phorton1/Arduino-boat-teensyBoat/docs/3dp.md

# teensyBoat.ino - 3DP

**[Home](readme.md)** --
**[Electronics](electronics.md)** --
**3DP** --
**[Commands](commands.md)**

repos: **[phorton1](https://github.com/phorton1)** --
**teensyBoat Firmware** --
**[teensyBoat App](https://github.com/phorton1/base-apps-teensyBoat/blob/master/docs/readme.md)** --
**[Boat Library](https://github.com/phorton1/Arduino-libraries-Boat/blob/master/docs/readme.md)** --
**[tbESP32 WiFi](https://github.com/phorton1/Arduino-boat-tbESP32/blob/master/docs/readme.md)** --
**[teensyWind Tester](https://github.com/phorton1/Arduino-boat-teensyWind/blob/master/docs/readme.md)** --
**[teensyGPS](https://github.com/phorton1/Arduino-boat-teensyGPS/blob/master/docs/readme.md)**

The teensyBoat PCB lives in a custom two-piece 3D-printed enclosure designed in
Fusion 360.  The enclosure holds the PCB securely, exposes all connectors, and mounts
to the installation surface.

TODO: insert Fusion 360 screenshot of enclosure design here

TODO: insert photo of final assembled device (PCB in enclosure) here

## Enclosure Files

Print-ready and slicer files are in `docs/3dp/`:

- **teensyBoatBottom.stl** -- main enclosure body
- **teensyBoatTop.stl** -- top cover
- **teensyBoatBottom.3mf** -- slicer project file for the bottom (Bambu/PrusaSlicer)
- **teensyBoatTop.3mf** -- slicer project file for the top
- **teensyBoatBottom_PETG.gcode** -- pre-sliced printer gcode for PETG filament
- **teensyBoatTop_PETG.gcode** -- pre-sliced printer gcode for PETG filament

The Fusion 360 source (`.f3d`) is not currently included in the repository.

---

**Next:** [Commands](commands.md)
