phorton1/Arduino-boat-teensyBoat/docs/3dp/seatalk_jxn_top.3mf

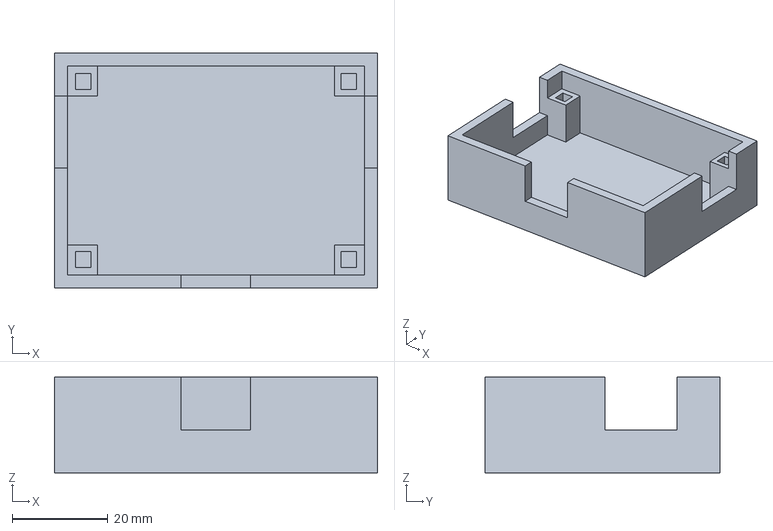
[picture p3: CAD file, 2026-11-11]
docs/3dp/seatalk_jxn_top.3mf
67.4 x 49.1 x 20.0 mm
