phorton1/Arduino-boat-teensyBoat/docs/kicad/board1/board1.step

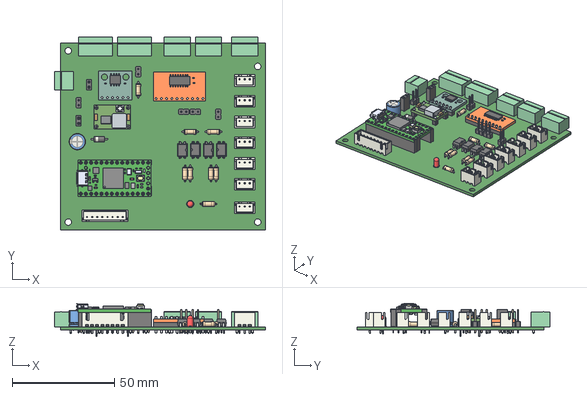
[picture p4: CAD file, 2026-01-05]
docs/kicad/board1/board1.step
103.2 x 94.4 x 16.3 mm
