phorton1/Arduino-boat-teensyBoat/docs/kicad/obs/SeatalkJxn/SeatalkJxn.step

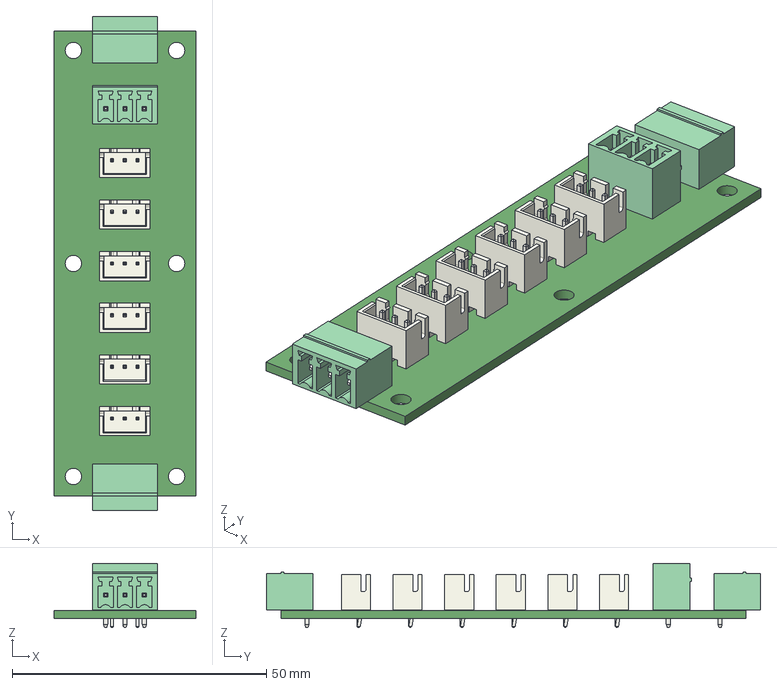
[picture p5: CAD file, 2025-11-19]
docs/kicad/obs/SeatalkJxn/SeatalkJxn.step
27.9 x 97.3 x 12.6 mm
