phorton1/Arduino-boat-teensyBoat/docs/kicad/seatalk_jxn/seatalk_jxn.step

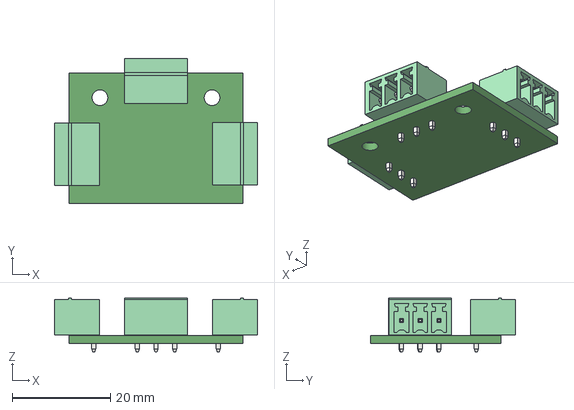
[picture p6: CAD file, 2026-11-11]
docs/kicad/seatalk_jxn/seatalk_jxn.step
41.4 x 29.6 x 10.9 mm
