phorton1/Arduino-boat-teensyBoat/docs/3dp/wire_clamp_3x2.3mf

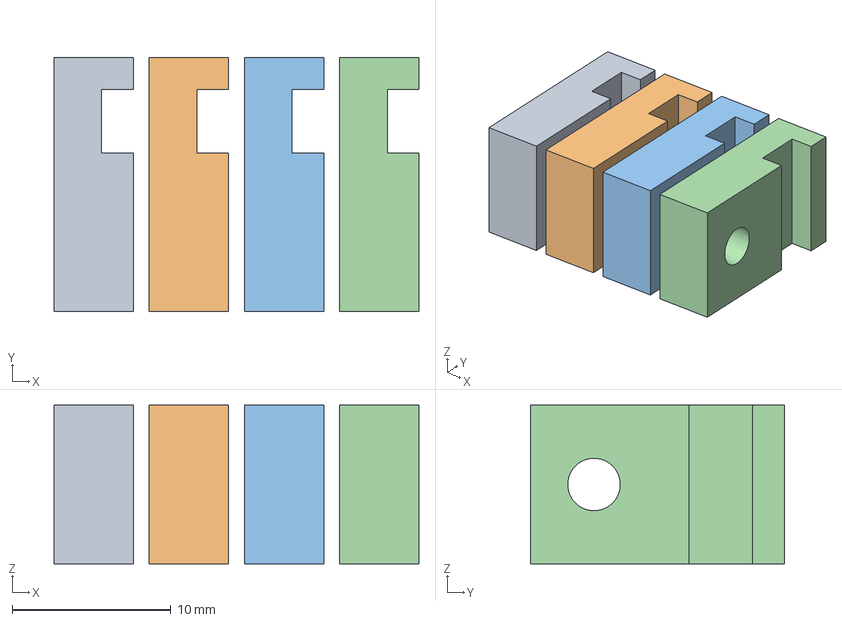
[picture p7: CAD file, 2026-11-11]
docs/3dp/wire_clamp_3x2.3mf
23.0 x 16.0 x 10.0 mm
wire_clamp_3x2.stl x 4
