phorton1/Arduino-boat-teensyBoat/docs/3dp/seatalk_jxn_bottom.3mf

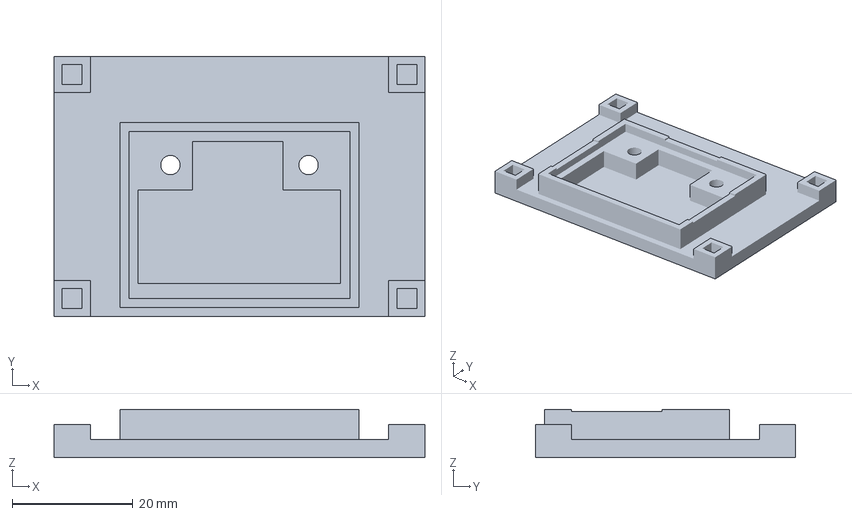
[picture p8: CAD file, 2026-11-11]
docs/3dp/seatalk_jxn_bottom.3mf
61.4 x 43.1 x 8.00 mm
