phorton1/Arduino-boat-teensyBoat/docs/3dp/teensyBoatTop.3mf

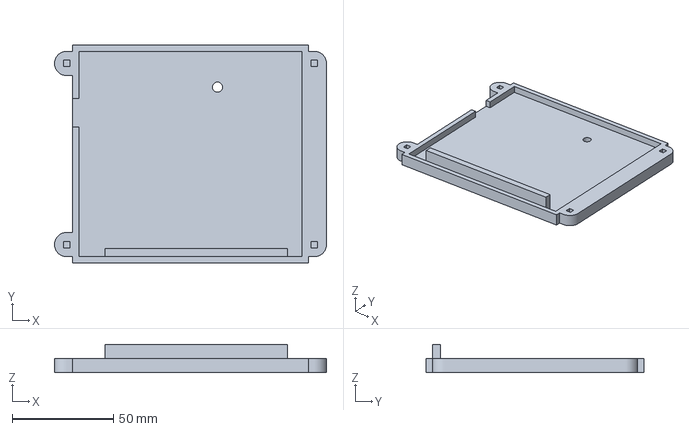
[picture p9: CAD file, 2026-09-30]
docs/3dp/teensyBoatTop.3mf
134.3 x 107.4 x 14.0 mm
