phorton1/Arduino-boat-teensyBoat/docs/3dp/teensyBoatBottom.3mf

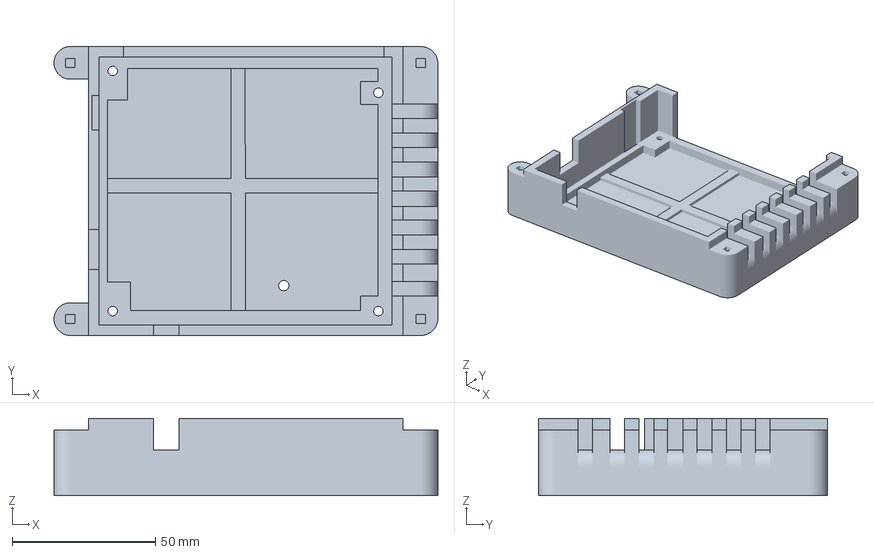
[picture p10: CAD file, 2026-09-30]
docs/3dp/teensyBoatBottom.3mf
134.0 x 100.8 x 27.0 mm
