phorton1/Arduino-boat-teensyBoat/(list of files, cad)

Other CAD files:
docs/3dp/seatalk_jxn_bottom.stl
docs/3dp/seatalk_jxn_top.stl
docs/3dp/teensyBoatBottom.stl
docs/3dp/teensyBoatBoxMagnets.f3d
docs/3dp/teensyBoatTop.stl
docs/3dp/wire_clamp_3x2.stl
