phorton1/Arduino-boat-teensyBoat/docs/kicad/seatalk_jxn/seatalk_jxn.kicad_pcb

## KiCad design docs/kicad/seatalk_jxn/seatalk_jxn.kicad_pcb (2026-11-11)

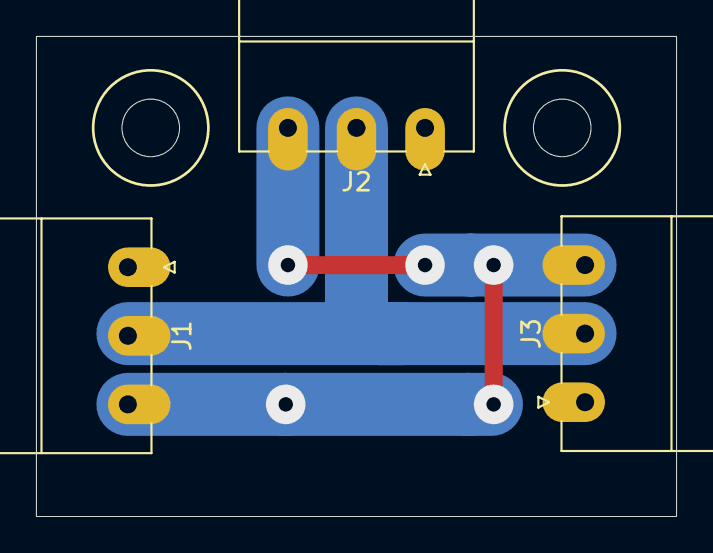
[picture p11: board seatalk_jxn.kicad_pcb from above]

Board: 2 copper layers, 35.6 x 26.7 mm, 3 parts (0 on the bottom side), 3 nets.

Parts:
J1, J2, J3: Conn_01x03; myPheonix3x3.81_right

Connections:
+12V: J1.2, J2.2, J3.2
DATA: J1.3, J2.3, J3.3
GND: J1.1, J2.1, J3.1
