phorton1/Arduino-boat-teensyBoat/docs/kicad/windBreadboard/windBreadboard.kicad_pcb

## KiCad design docs/kicad/windBreadboard/windBreadboard.kicad_pcb (2026-02-14)

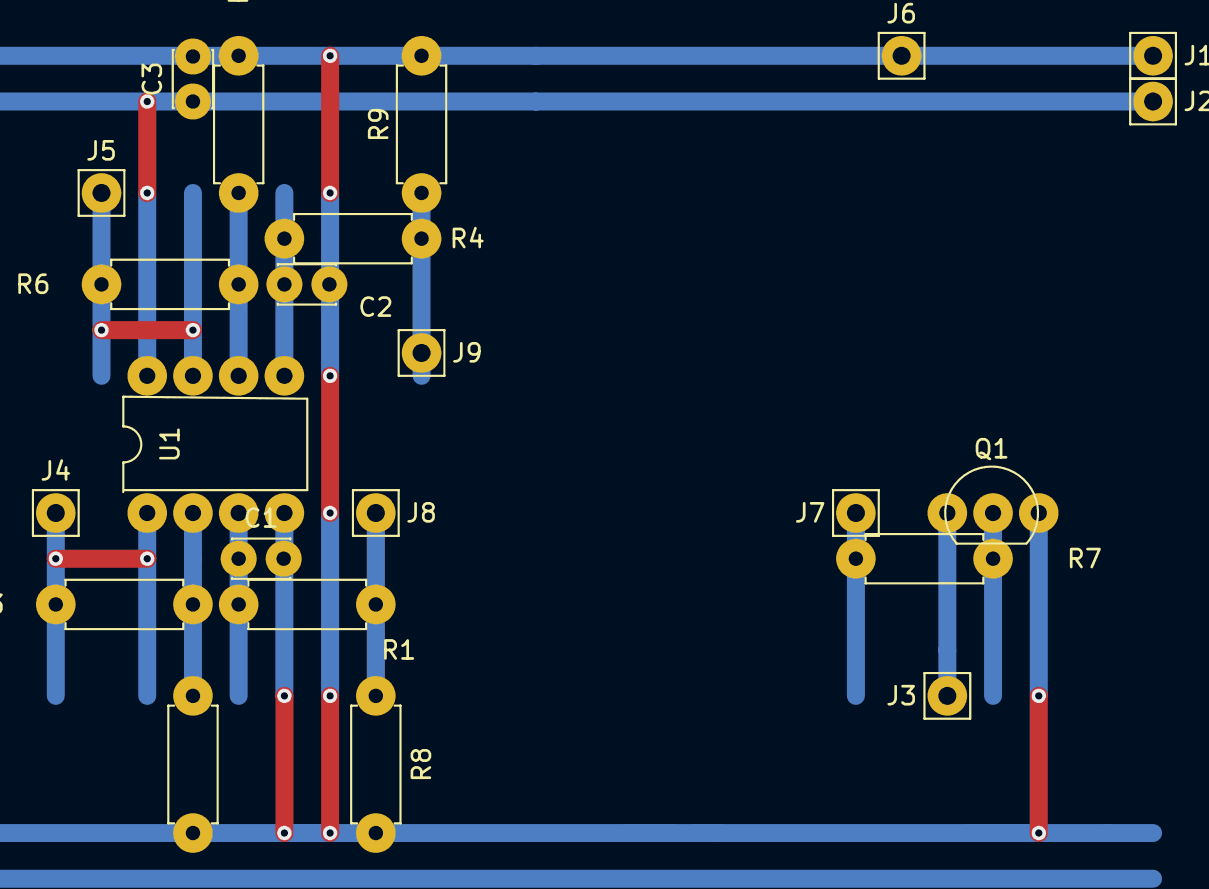
[picture p12: board windBreadboard.kicad_pcb from above]

Board: 2 copper layers, 23 parts (0 on the bottom side), 13 nets.

Parts:
C1, C2, C3: 100nf; myCapCeramicSmall
J1: ST_GND; myPinHeader_1x01
J2: ST_12V; myPinHeader_1x01
J3: WIND_PULSE_YELLOW; myPinHeader_1x01
J4: SIGNALA_GREEN; myPinHeader_1x01
J5: SIGNALB_BLUE; myPinHeader_1x01
J6: GP8_GND; myPinHeader_1x01
J7: GP8_PULSE_YELLOW; myPinHeader_1x01
J8: GP8_PWMA_GREEN; myPinHeader_1x01
J9: GP8_PWMB_BLUE; myPinHeader_1x01
Q1: BC546; myTransistor
R1, R2, R4, R5, R8, R9: 10K; myResistor
R3, R6: 22K; myResistor
R7: 1K; myResistor
U1: LM358; myDip8

Connections:
+12V: C3.1, J2.1, U1.8
GND: C1.2, C2.2, C3.2, J1.1, J6.1, Q1.3, R2.2, R5.2, R8.2, R9.2, U1.4
unnamed: C1.1, R1.1, U1.3
unnamed: C2.1, R4.1, U1.5
unnamed: Q1.2, R7.1
unnamed: R2.1, R3.2, U1.2
unnamed: R5.1, R6.2, U1.6
PWMA_GREEN: J8.1, R1.2, R8.1
PWMB_BLUE: J9.1, R4.2, R9.1
SIGNALA_GREEN: J4.1, R3.1, U1.1
SIGNALB_BLUE: J5.1, R6.1, U1.7
SPEED_PULSE_YELLOW: J7.1, R7.2
WIND_PULSE_YELLOW: J3.1, Q1.1
