phorton1/Arduino-boat-teensyBoat/docs/kicad/board1/board1.kicad_pcb

## KiCad design docs/kicad/board1/board1.kicad_pcb (2026-01-08)

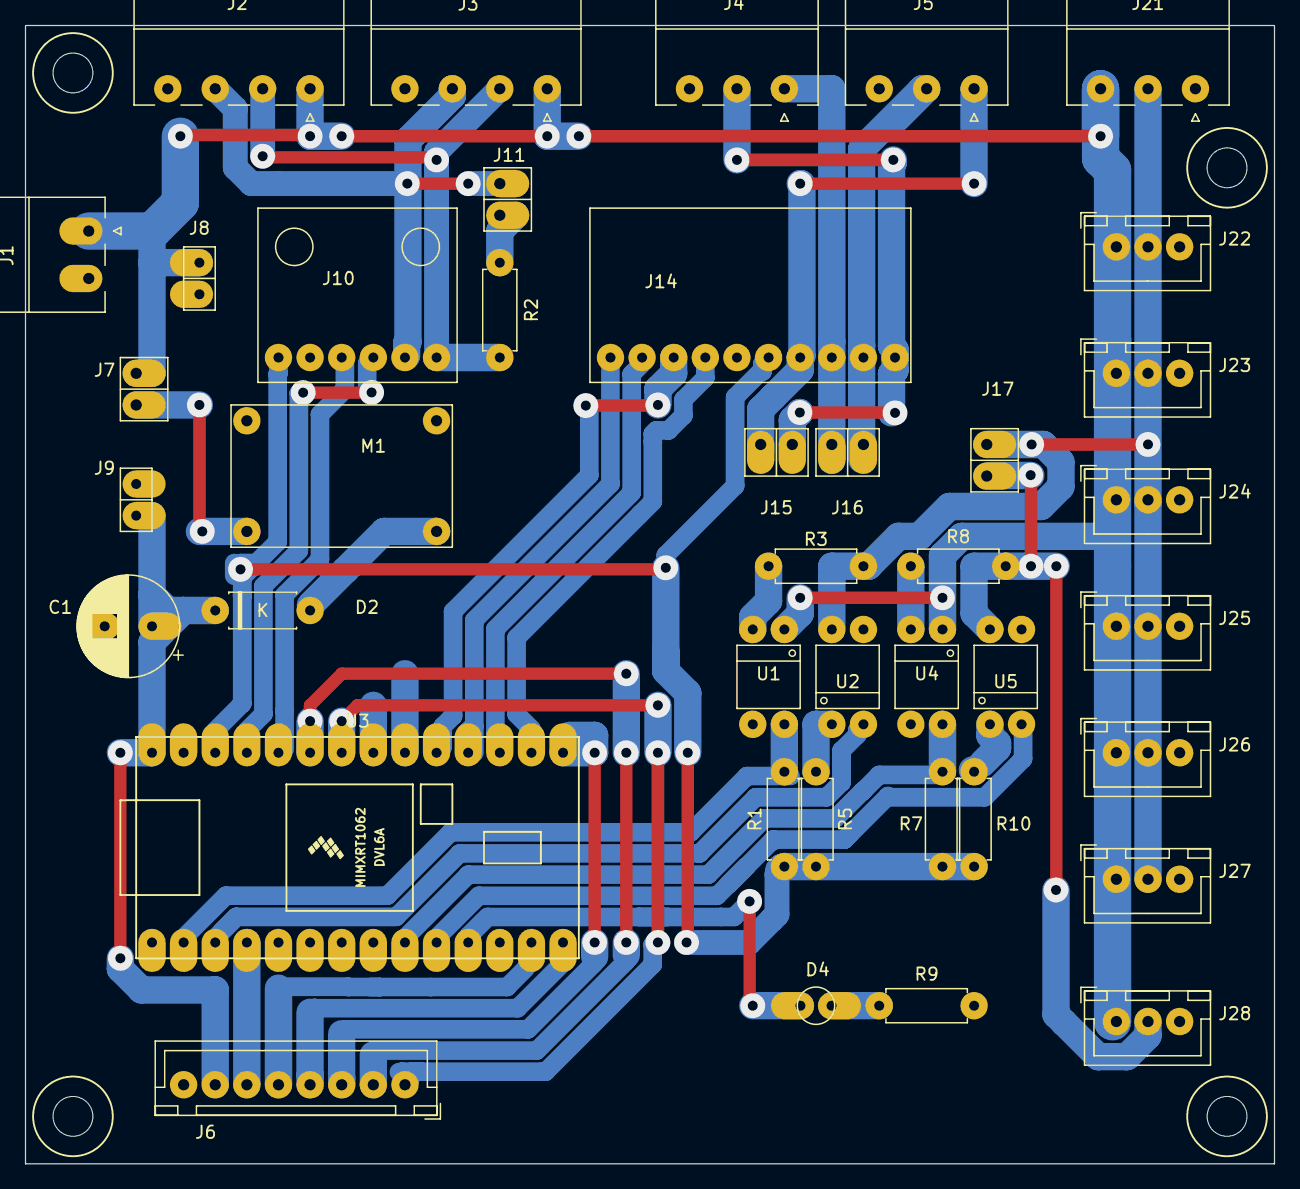
[picture p13: board board1.kicad_pcb from above]

Board: 2 copper layers, 100.3 x 91.4 mm, 40 parts (0 on the bottom side), 37 nets.

Parts:
C1: 100uf; CP_my100uf
D2: 1N5819; myDiodeSchotsky
D4: ALIVE_LED; led_small_red
J1: INST_POWER; myPheonix2x3.81_right
J2, J3: NMEA2000; myPheonix4x3.81_right
J4: 83A; myPheonix3x3.81_right
J5: 83B; myPheonix3x3.81_right
J6: TEST_RIG; myJSTx08
J7: BUCK_PWR; pinHeader1x2
J8: 12V_TEST; pinSocket1x2
J9: 5V_TEST; pinSocket1x2
J10: SN65HVD230; CANBUS_Module1
J11: CAN_TERMINATOR; pinHeader1x2
J14: MAX3232; MAX3232_Module
J15: AIS; pinHeader1x2
J16: GPS; pinHeader1x2
J17: ST_CONNECTED; pinHeader1x2
J21: ST1; myPheonix3x3.81_right
J22, J23, J24, J25, J26, J27: ST1; myJSTx03
J28: ST2; myJSTx03
M1: BUCK01; myMini360BuckConverter
R1: 10K; myResistor
R2: 120; myResistor
R3, R8: 4.7K; myResistor
R5, R9, R10: 220; myResistor
R7: 10k; myResistor
U1, U2, U4, U5: TLP521; myDip4
U3: myTeensy4.0; teensy40

Connections:
83A_IN: J4.2, J14.10, J15.2
83A_OUT: J4.1, J14.8, J16.1
83B_IN: J5.2, J14.9, J16.2
83B_OUT: J5.1, J14.7, J15.1
+3V3: J10.1, J14.6, R1.1, R5.2, R7.1, R10.2, U3.26
+5V: C1.1, D2.1, J6.7, J9.1, U3.28
+12V: J1.1, J2.1, J3.1, J7.2, J8.1, J21.3, J22.1, J23.1, J24.1, J25.1, J26.1, J27.1, J28.1, U1.1, U4.1
ALIVE_LED: D4.2, U3.11
CANH: J2.3, J3.3, J10.5, J11.2
CANL: J2.2, J3.2, J10.6, R2.1
CRX: J10.3, U3.24
CTX: J10.4, U3.25
GND: C1.2, J1.2, J2.4, J3.4, J4.3, J5.3, J6.8, J8.2, J9.2, J10.2, J14.5, J21.1, J22.3, J23.3, J24.3, J25.3, J26.3, J27.3, J28.3, M1.1, M1.2, R9.2, U1.3, U2.3, U3.1, U3.27, U4.3, U5.3
MISO-UDP_ENABLE: J6.4, U3.14
MOSI-GP: J6.5, U3.13
unnamed: D2.2, M1.3
unnamed: D4.1, R9.1
unnamed: J7.1, M1.4
unnamed: J11.1, R2.2
unnamed: R3.1, U1.2
unnamed: R5.1, U2.1
unnamed: R8.1, U4.2
unnamed: R10.1, U5.1
RX1: R1.2, U1.4, U3.2
RX2: R7.2, U3.9, U4.4
RX3: J14.2, U3.17
RX4: J14.1, U3.18
RX5-T_CS: J6.2, U3.23
SCLK-GP: J6.3, U3.15
SPEED_PULSE-LCD_CS: J6.6, U3.4
ST1: J17.2, J21.2, J22.2, J23.2, J24.2, J25.2, J26.2, J27.2, R3.2, U2.4
ST2: J17.1, J28.2, R8.2, U5.4
TX1: U2.2, U3.3
TX2: U3.10, U5.2
TX3: J14.4, U3.16
TX4: J14.3, U3.19
TX5-LCD_DC: J6.1, U3.22
