phorton1/Arduino-boat-teensyBoat/docs/kicad/obs/SeatalkJxn/SeatalkJxn.kicad_pcb

## KiCad design docs/kicad/obs/SeatalkJxn/SeatalkJxn.kicad_pcb (2025-11-19)

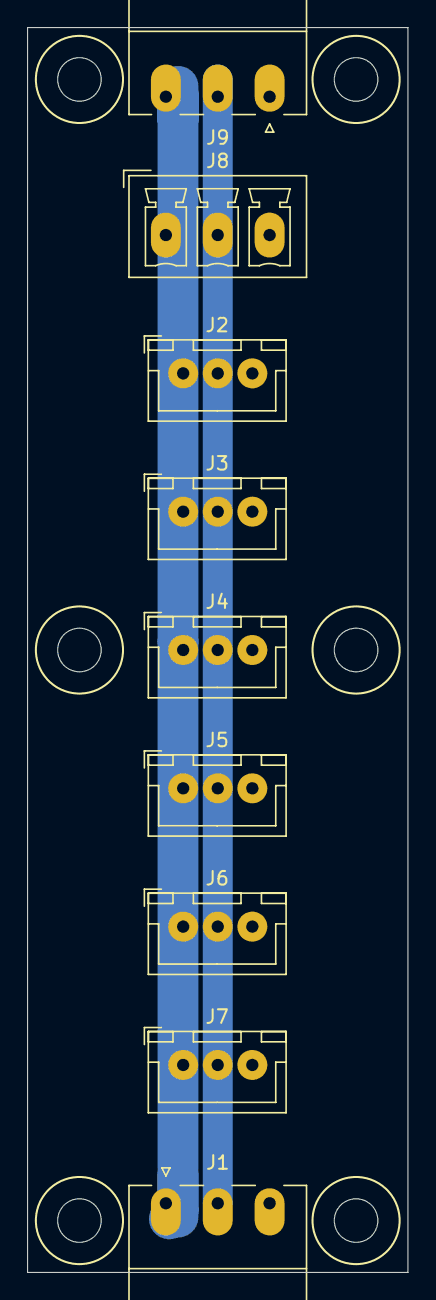
[picture p14: board SeatalkJxn.kicad_pcb from above]

Board: 2 copper layers, 27.9 x 91.4 mm, 9 parts (0 on the bottom side), 3 nets.

Parts:
J1, J9: Conn_01x03; myPheonix3x3.81_right
J2, J3, J4, J5, J6, J7: Conn_01x03; myJSTx03
J8: Conn_01x03; myPhoenix3x3.81_vertical

Connections:
+12V: J1.1, J2.1, J3.1, J4.1, J5.1, J6.1, J7.1, J8.1, J9.3
GND: J1.3, J2.3, J3.3, J4.3, J5.3, J6.3, J7.3, J8.3, J9.1
data: J1.2, J2.2, J3.2, J4.2, J5.2, J6.2, J7.2, J8.2, J9.2
