phorton1/Arduino-boat-teensyBoat/docs/kicad/obs/initial_board/initial_board.kicad_pcb

## KiCad design docs/kicad/obs/initial_board/initial_board.kicad_pcb (2025-09-08)

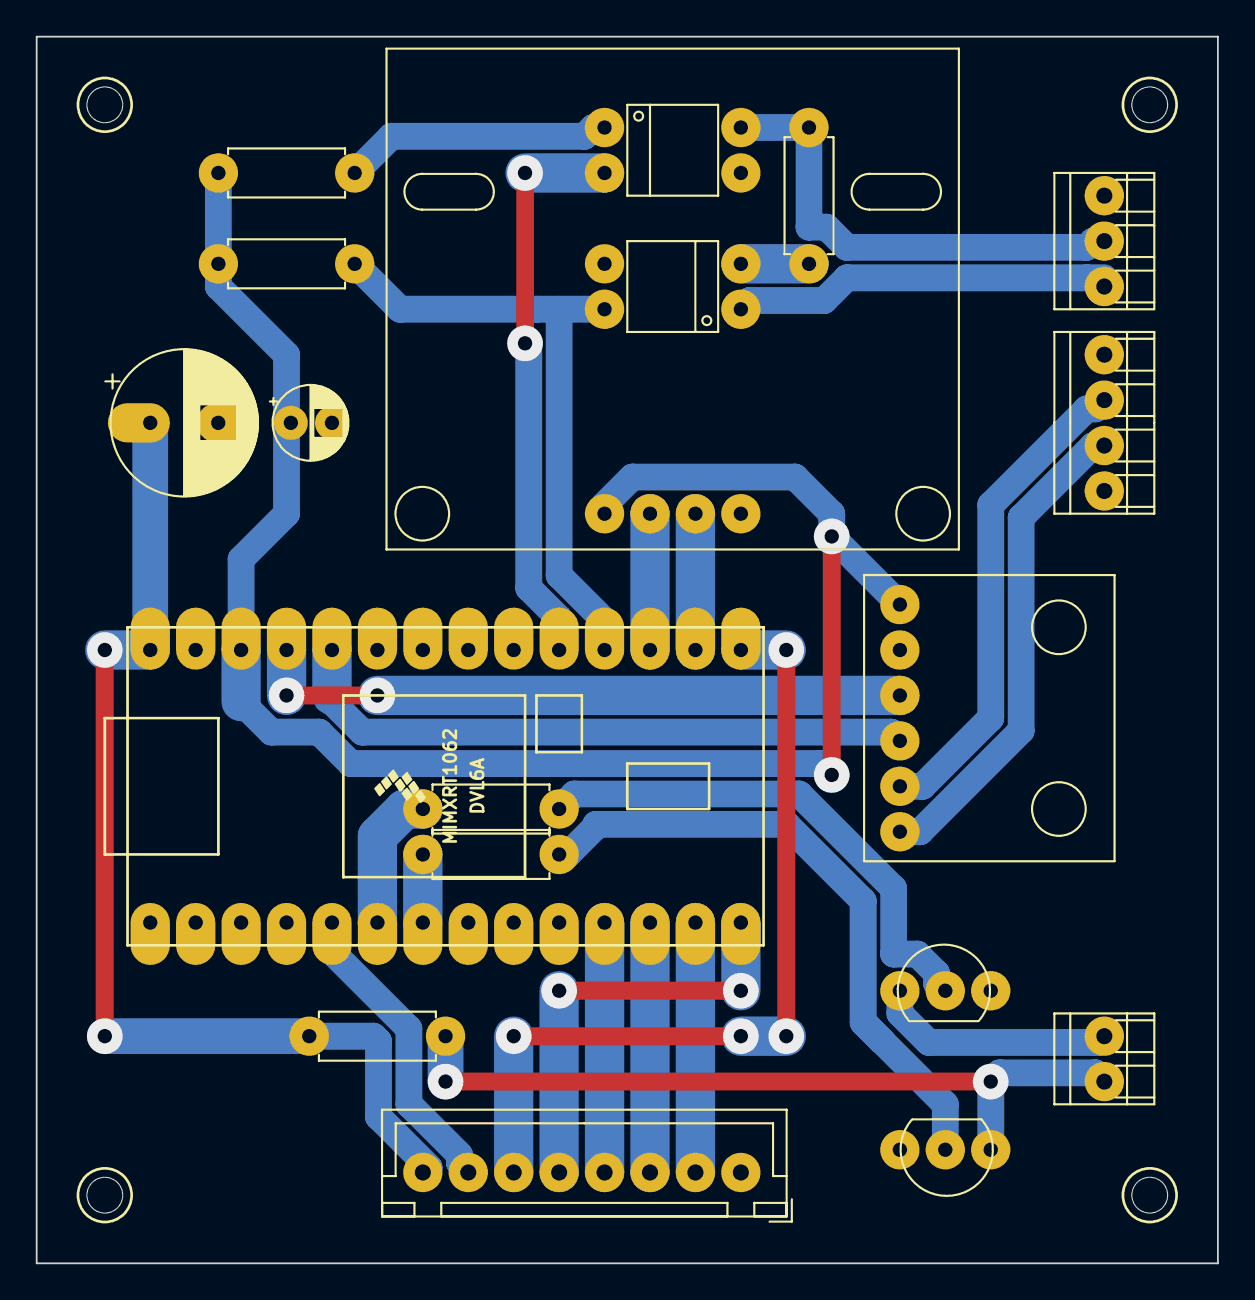
[picture p15: board initial_board.kicad_pcb from above]

Board: 2 copper layers, 66.0 x 68.6 mm, 19 parts (0 on the bottom side), 27 nets.

Parts:
C1: 47uf; CP_my10uf
C2: 100uf; CP_my100uf
J1: RS232-1; RS232_Module
J2: CAN_MODULE; CANBUS_Module1
J3: NMEA200; myTerminalBlock_2.54x04
J4: Seatalk; myTerminalBlock_2.54x03
J5: TEST_ST50; myTerminalBlock_2.54x02
J6: TE_DISPLAY; myJSTx08
Q1, Q2: BC547; myTransistor
R1, R5: 100; myResistor
R2, R3: 220; myResistor
R4, R6: 4.7K; myResistor
U1: myTeensy4.0; teensy40
U2: TLP521-1; myDip4
U3: TLP521-2; myDip4

Connections:
+3V3: C1.1, J1.1, J2.1, R3.2, R4.1, U1.26
+5V: C2.1, J6.8, R2.2, U1.28
+12V: J4.3, U2.1
CANH: J2.5, J3.2
CANL: J2.6, J3.3
CRX: J2.4, U1.24
CTX: J2.3, U1.25
GND: C1.2, C2.2, J1.4, J2.2, J3.4, J4.1, J6.1, Q1.3, Q2.3, U1.27, U2.3, U3.3
LCD_CS: J6.3, U1.12
LCD_DC: J6.4, U1.11
MISO: J6.5, U1.14
MOSI: J6.2, U1.13
unnamed: J4.2, R6.2, U3.4
unnamed: Q1.2, R1.1
unnamed: Q2.2, R5.1
unnamed: R3.1, U3.1
unnamed: R6.1, U2.2
RX3: J1.2, U1.17
RX4: R4.2, U1.18, U2.4
SCLK: J6.6, U1.15
SPEED_PULSE: R5.2, U1.6
ST50_LOG_GREEN: J5.1, Q2.1
ST50_WIND_YELLOW: J5.2, Q1.1, R2.1
TX3: J1.3, U1.16
TX4: U1.19, U3.2
T_CS: J6.7, U1.5
WIND_PULSE: R1.2, U1.7
