phorton1/Arduino-boat-teensyBoat/docs/kicad/obs/max3232_board/max3232_board.kicad_pcb

## KiCad design docs/kicad/obs/max3232_board/max3232_board.kicad_pcb (2025-09-01)

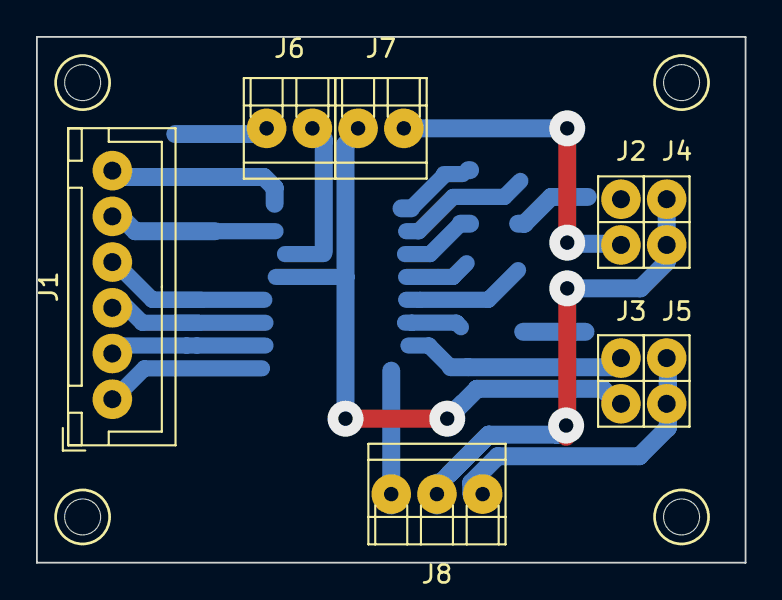
[picture p16: board max3232_board.kicad_pcb from above]

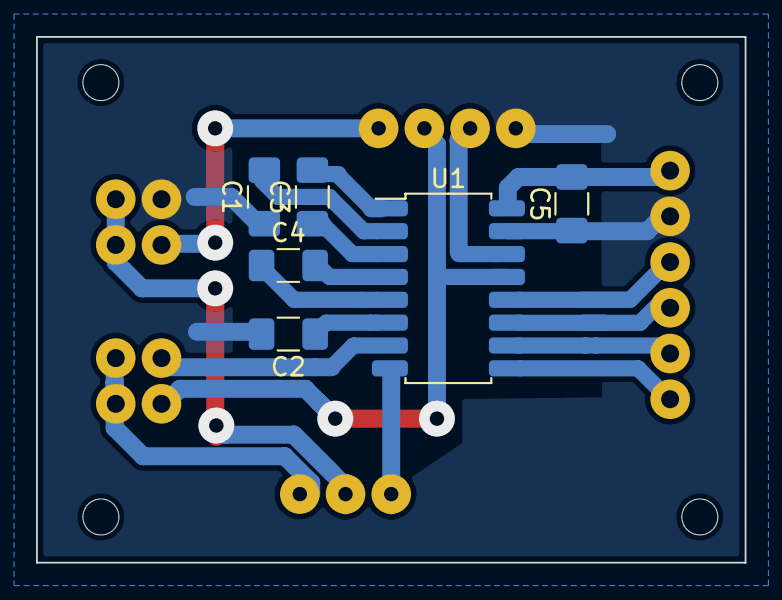
[picture p17: board max3232_board.kicad_pcb from below]

Board: 2 copper layers, 39.4 x 29.2 mm, 14 parts (6 on the bottom side), 19 nets.

Parts:
C1, C2, C3, C4, C5: 100nf; C_1206_3216Metric_Pad1.42x1.75mm_HandSolder
J1: Conn_01x06; myJSTx06
J2: JMP1A; myPinHeader_1x02
J3: JMP2A; myPinHeader_1x02
J4: JMP1B; myPinHeader_1x02
J5: JMP2B; myPinHeader_1x02
J6: VHF_0183A; myTerminalBlock_2.54x02
J7: VHF_0183B; myTerminalBlock_2.54x02
J8: E80_0183; myTerminalBlock_2.54x03
U1: MAX3232; SOIC-16_4.55x10.3mm_P1.27mm

Connections:
+3V3: C5.2, J1.6, U1.16
E80-: J4.1, J4.2, J8.2
E80_IN: J5.1, J5.2, J8.1
GND: C1.1, C2.2, C5.1, J1.5, J2.2, J6.1, U1.15
MPU_IN1: J1.3, U1.11
MPU_IN2: J1.2, U1.10
MPU_OUT1: J1.4, U1.12
MPU_OUT2: J1.1, U1.9
unnamed: C1.2, U1.2
unnamed: C2.1, U1.6
unnamed: C3.1, U1.3
unnamed: C3.2, U1.1
unnamed: C4.1, U1.5
unnamed: C4.2, U1.4
RS232_IN1: J7.1, U1.13
RS232_IN2: J8.3, U1.8
RS232_OUT1: J6.2, U1.14
RS232_OUT2: J3.2, U1.7
VHF_AIS-: J2.1, J7.2
