phorton1/Arduino-boat-teensyBoat/(commit log)

2025-08-28 initial commit - direct port of NMEA_SENSOR project using teensy 4.0 and SN65HVD230 module
2025-09-01 build max3232_board - doesnt work - see comments and TEST_IT which outputs slow square wave
    [max3232_board.kicad_pcb, max3232_board.sch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]
2025-09-01 added teensyBoat/readme.md; slight cleanup to Arduino-libraries-boat/instSimulator.h too
2025-09-01 started teensyBoat mother_board; gave one more try to max3232_board - no joy
    [NMEA0183_connections.kicad_pcb, NMEA0183_connections.sch, ST50_Wind_Tester.kicad_pcb, ST50_Wind_Tester.sch, mother_board.kicad_pcb, mother_board.sch]
2025-09-08 cleaned up teensyBoat implementation a bit by re-organizing /Arduino/libraries/boat
2025-09-08 created initial intetgrated teensyBoat PCB (docs/kicad/initial_board)
    [initial_board.kicad_pcb, initial_board.sch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]
2025-09-14 teensyBoat (perl, ino, and library) first working BINARY_PROTOCOL
2025-09-18 change teensyBoat startup defaults; get rid of obs text file
2025-09-21 added winProg to Perl app and support in INO and instSimularor. Fixed some bugs in tbListCtrl
    [teensyBoat.ino]
2025-10-21 added water current simulation (heading, water_speed, current_angle, current_speed) and calculateOverGround for cog and sog - added calculateOverGround - pain in the ass reworking calculateApparentWi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
    [teensyBoat.ino]
2025-10-22 add Pub::WX::Frame::setHowRestore and $ini_file; clean up window::new() calls; clean up uses; add / clean up $dbg constants
2025-10-23 teensyBoat: - winBoat - added new fields - winST - separate sends from receives Simulator: - Turning Routing off no longer turns Autopilot off - add & utilitize XTE and TRIP/TOTAL simulation - cleanu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
    [teensyBoat.ino]
2025-11-04 improved NMEA2000 and ST messages - added generic headingTo and distanceTo methods to boatSimulator.h - added and advertise more organized PGNS in inst2000 - added date/time xmit to ST gps instrument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
2025-11-06 switched breadboard to orange MAX3232 boards; prep for testing two NMEA0183 ports
2025-11-08 added 2nd NMEA0183 port (red MAX3232 board) with FWD and UI; simplified Monitoring scheme with UI - redesigned breadboard - tested VHF -> E80 with forwarding and without breadboard - consistent monit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
    [teensyBoat.ino]
2025-11-10 cleaned up INO Help messages and command implementations added several new decoded ST Log/Speed messages implemented ST50 speed pulses added LAMP=x ST instrument specific command; figured out E80/GX2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
    [teensyBoat.ino]
2025-11-10 designed new board0 using relays for passive/active control and lots of features
    [board0.sch]
2025-11-16 added new teensyBoat PCB (with MAX3333 and better footprints) kicad projects board0 (using relays) and board0_max33333 (using IC analog switch)
    [board0.kicad_pcb, board0_max3333.kicad_pcb, board0_max3333.sch]
2025-11-19 create actual boat teensyBoat pcb board1; move other kicad stuff to _obs; add/fix kicad footprints
    [NMEA0183_connections.sch, ST50_Wind_Tester.kicad_pcb, ST50_Wind_Tester.sch, SeatalkJxn.kicad_pcb, SeatalkJxn.sch, SeatalkJxn.step, board0_max3333.kicad_pcb, board0_max3333.sch]
2025-11-24 fix incorrect CRX/CTX routing
    [board1.kicad_pcb, board1.sch]
2025-11-24 added experimental tbESP32 serial<->UDP teensyBoat.ino myIOT forwarding device
2025-11-24 renamed 8 pin connector net names in accordance with comments
    [board1.kicad_pcb, board1.sch]
2025-11-24 added global udp_enable for SERIAL_ESP32 turned on by PIN_UDP_ENABLE in instSimulator.cp - improved 8 pin connector comments - only output UDP packets if both SERIAL_ESP32 is defined and PIN_UDP_ENAB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
2026-01-05 reworked existing teensyBoat PCB for tbESP32 connector - ran Serial5 (RX5 & TX5) to 8 pin connector - updated schematic and PCB with comments - changed PIN_UDP_ENABLE from 4 to 12 (mosi)
    [board1.kicad_pcb, board1.sch, board1.step]
2026-01-06 teensyBoat multi-repo change in prep for ACTUAL BOAT monitoring - rename boat->boat_sim - rename instruments->inst_sim - rename "boat" window to "Boat Sim" - rename BINARY_TYPE_BOAT -> BINARY_TYPE_SI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
2026-01-08 created 2nd teensyBoat PCB then modified Pheonix connector pads and deleted plot/gcode
    [board1.kicad_pcb, board2.kicad_pcb, board2.sch]
2026-01-08 3D Print prelimnary teensyBoatMount1
    [teensyBoatMount1.3mf, teensyBoatMount1.stl]
2026-01-09 3D print 2nd teensyBoat box
    [teensyBoatBottom.3mf, teensyBoatBottom.stl, teensyBoatMount1.3mf, teensyBoatMount1.stl, teensyBoatTop.3mf, teensyBoatTop.stl]
2026-01-13 latest teensyBoat changes from apartment
2026-01-17 reworked Pulse UI and implementation to test HH oscilloscope and provide for more flexibility in the future
    [teensyBoat.ino]
2026-01-23 Implemented General Purpose Connector (GP8) modes: OFF,PULSE,ESP32,NEO6M, with UI, save to EPROM, etc - Features turned on or off at runtime - Code can be eliminated with #defines - Protects pinouts 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
2026-02-03 reworked neoGPS to be callable from new teensyGPS.ino program - renamed neo6M_GPS.cpp to neoGPS.cpp - added neoGPS.h - modified teensyBoat UI and instSimulator to support NEOST and NEO2000 "GP8" mode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
    [teensyBoat.ino]
2026-02-06 remove UI/implementation and move neoGPS to teensyGPS repo - cleanup NMEA2000 device (teensyBoat vs teensyGPS) initialization - update preferences.txt's to back two plugs on Lenovo3
2026-02-11 checkin kicad design for theoretical PWM/opAmp based ST50 Wind Instrument tester
    [windBreadboard.kicad_pcb, windTester.kicad_pcb, windTester.sch]
2026-02-12 changed pulseHz to a float for sub 1 hz testing
2026-02-12 played around again with idea of a windTester opAmp driven breadboard
    [windBreadboard.kicad_pcb]
2026-02-13 Panic Checking - windTester PCB right after coPilot tells me it wont generate 2-8V preceding new design
    [windTester.kicad_pcb, windTester.sch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]
2026-02-14 didn't mill. Changed to LM358 dip8 and windBreadboard for testing ST50 Wind & Speed
    [windBreadboard.kicad_pcb, windBreadboard.sch, windTester.kicad_pcb, windTester.sch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]
2026-02-14 ST50 WIND DAY - Added GP8 "Wind Mode", cleanup of GP8 and test_mode, including implemented raw PWM and non-working Simulated WindAngle to PWM math - fixed a lot of comments, made members out of instS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
    [teensyBoat.ino]
2026-02-17 rework GP8 ST Testing modes APIs - add WIND_CIRCLE ui for explicit calibration/measurement of ST50 Wind Instrument windTester cycle
    [teensyBoat.ino]
2026-02-20 rework teensyGPS incluging new pins, refactoring it and teensyBoat ST stuff, NMEA2000 init, and monitoring commands
    [teensyBoat.ino]
2026-04-23 Added http tooling for CLAUDE to be able to see/run teensyBoat
2026-04-24 updated teensyBoat documentation chain
2026-05-10 teensyBoat documentation pass
2026-05-10 add teensyBoat simulator water temperature; output in instST_out::logInst(), verified it comes back in tracks on the E80. Added WT=command to teensyBoat.ino and display in wx winBoatSim
2026-05-11 added Boat Library: new_st_knowledge.md and links from teensyBoat.ino and main Boat library readme's
2026-05-16 rework all teensyBoat repos documentation particularly with regards to command tables and the boat driving guide(s)
2026-09-30 update teensyBoat box to magnets
    [teensyBoatBottom.3mf, teensyBoatBottom.stl, teensyBoatBoxMagnets.f3d, teensyBoatTop.3mf, teensyBoatTop.stl]
2026-11-11 make ST junction box PCB's and 3d printed boxes
